gavin-lusby/STM32-Trash-Sorter/README.md

# STM32-Trash-Sorter
Trash Sorter Prototype to sort different kinds of trash in a commercial food service environment

Design Document and Changelog included. They walk through everything you need to know in depth. 

Refer to Design Document.pdf and Design Process Review.pdf

Pictures and simple explanation of how the project functions are included in Project Overview.pdf

1lusbygav is gavin-lusby (both me)
